made-iit/deltaflex/README.md

# DeltaFlex

This repository contains the source files and an information page on the DeltaFlex robot.
Further information is available at the [project page](https://made-iit.github.io/deltaflex/).
