made-iit/deltaflex/index.md

---
title: "DeltaFlex: an Additively Manufactured Monolithic Delta Robot with Compliant Joints"
---

# DeltaFlex: an Additively Manufactured Monolithic Delta Robot with Compliant Joints

<hr style="height:1px"> 

Alberto Parmiggiani, Emilio Ottonello, Seyyed Masoud Kargar, Mario Baggetta, Guangbo Hao, Giovanni Berselli

<video width=100% controls src="media/video_deltaflex.mp4" type="video/mp4"></video>

### Links

##### [Source files](https://github.com/made-iit/deltaflex) - [Preprint](https://github.com/made-iit/deltaflex/raw/main/media/preprint_deltaflex.pdf) - [Paper]()* - [Bibtex](https://github.com/made-iit/deltaflex/raw/main/media/bibtex.bib)
*[TODO: add paper link when available online] 

### Abstract

This study presents the design and validation of a compliant Delta robot created through additive manufacturing (AM) with a monolithic structure. The use of AM expedites the development cycle of robots, enabling faster prototype development and deployment, as well as facilitating experimentation with new robot kinematics. The use of compliant joints poses a challenge in achieving substantial workspaces for robots. However, parallel architectures are well-suited for implementing flexible joints because they require lower ranges of motion for individual joints than serial architectures. Thus the Delta configuration was chosen for this study. A Design for Additive Manufacturing (DfAM) strategy was adopted to minimize the need for support structures and maximize mechanical strength. The overall performance of the Delta was evaluated quantitatively in terms of stiffness and precision. The stiffness test aimed to measure the device's capability to withstand applied loads, while the repeatability test assessed the robot's precision and accuracy. Moreover, FEM verification was adopted. Structural simulations are a powerful tool for verifying the experimental results of a robotic system. The approach presented in this work offers an interesting avenue for robot design with significant potential for future advancements and practical applications and sheds light on the trade-offs that designers should consider when adopting this methodology.

<hr style="height:1px"> 

**Published in Proc. of ASME IDETC-CIE 2023 - © 2023 ASME**
