made-iit/deltaflex/hardware/bom.md

# Bill of materials

To assemble the DeltaFlex the following objects need to be purchased:

- 3xNema 17 stepper motors;
- 3xTiming pulleys for S2M belt, 14 teeth;
- 3xS2M timing belt; 
- 12xball bearings (inner diameter 4 mm, outer diameter 13 mm, width 5 mm);
- 12xdowel pin (diameter 4 mm, length 24 mm);
- 6xm4 brass inserts;
- 6xm4 flat head screws;
- 6xm4 set screws (length 25 mm);
- 6xm4 bolts.
