made-iit/deltaflex/hardware/mws_021_p_003.stp

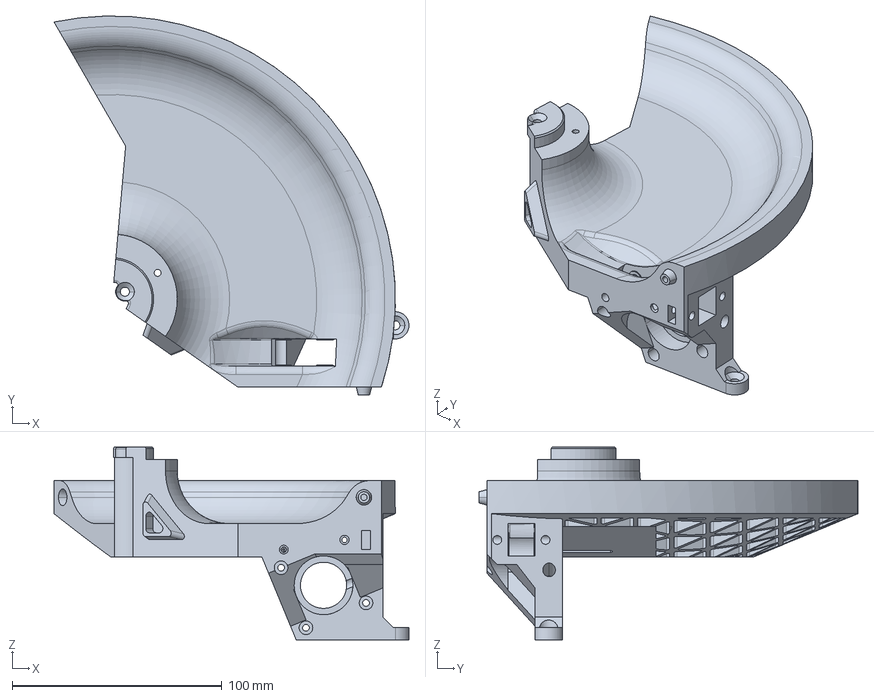
[picture p1: CAD file, 2023-08-22, last stored version]
hardware/mws_021_p_003.stp
169.3 x 180.7 x 92.0 mm
