made-iit/deltaflex/hardware/mws_021_p_005.stp

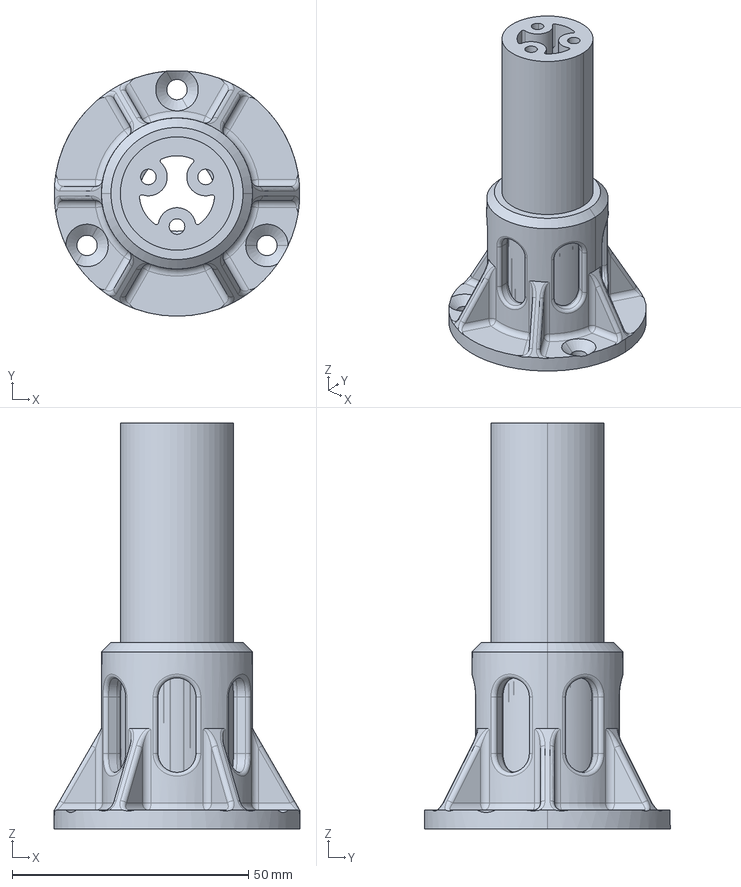
[picture p2: CAD file, 2023-08-22, last stored version]
hardware/mws_021_p_005.stp
52.0 x 52.0 x 86.0 mm
