made-iit/deltaflex/hardware/mws_021_a_001_assembly_instructions.md

# DeltaFlex assembly instructions

## Before you begin

Note: The assembly of the cover and of the driving electronics are left out of the current assembly as one might want to make the covers in a different way or use different driving electronics.

## Assembly sequence

1. After sourcing all components start by assembling the six `MWS_021_G_002` sub-assemblies.
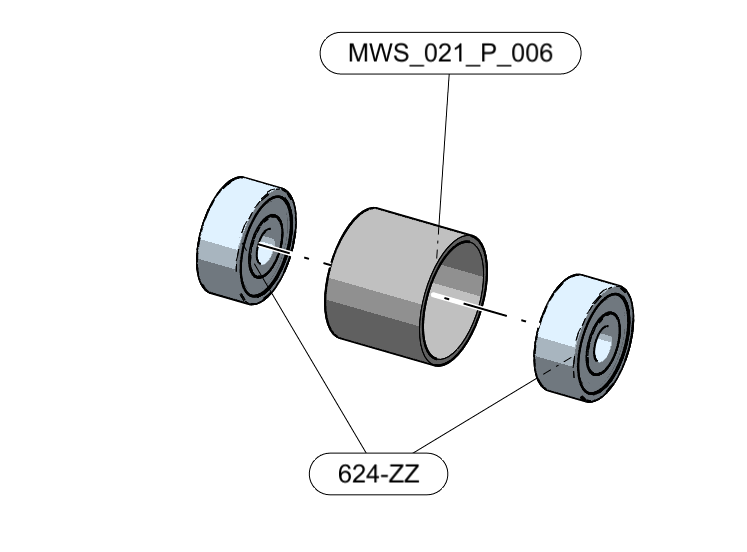
[picture p3: hardware/assembly_illustrations/illustration_01_bearings_g002.png]

1. Proceed to the assembly of the three `MWS_021_G_001` by:
   1. assemblies by assembling the stepper motors.
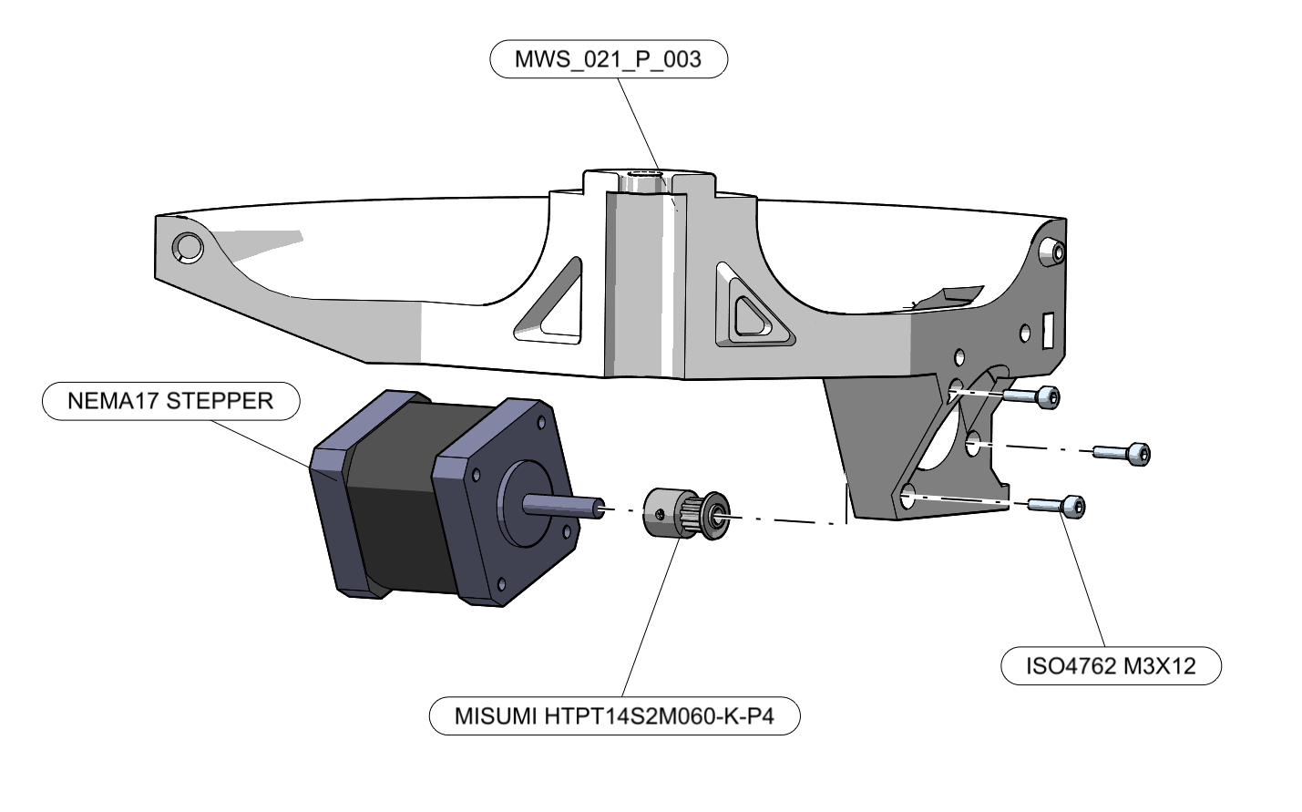
[picture p4: hardware/assembly_illustrations/illustration_02_support_g001.png]
   

   1. Insert bearing groups and fix with pins
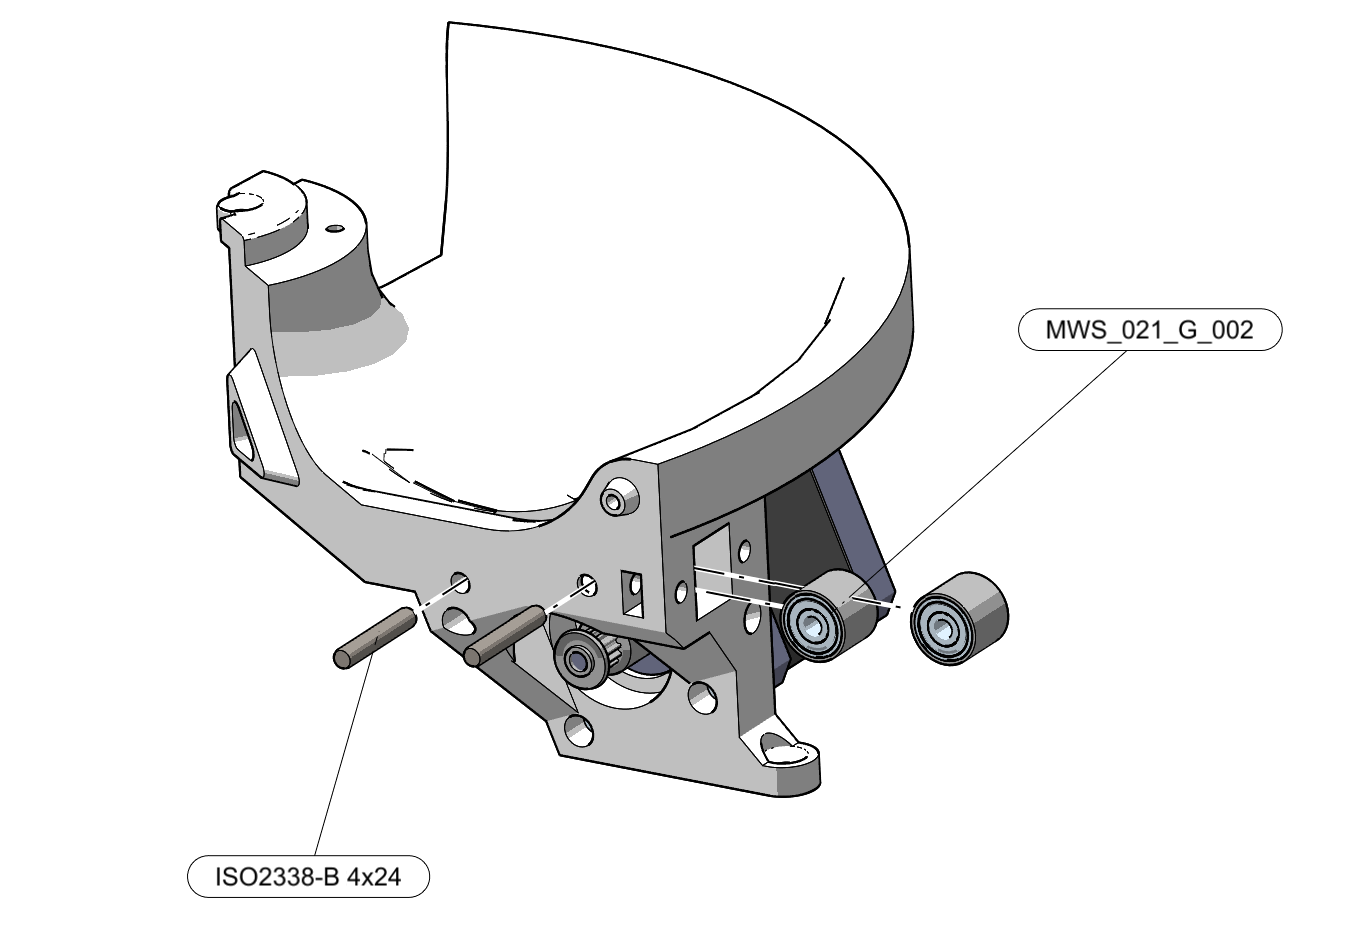
[picture p5: hardware/assembly_illustrations/illustration_04_bearings_insertion.png]

   1. Assemble tensioner set screws and nuts
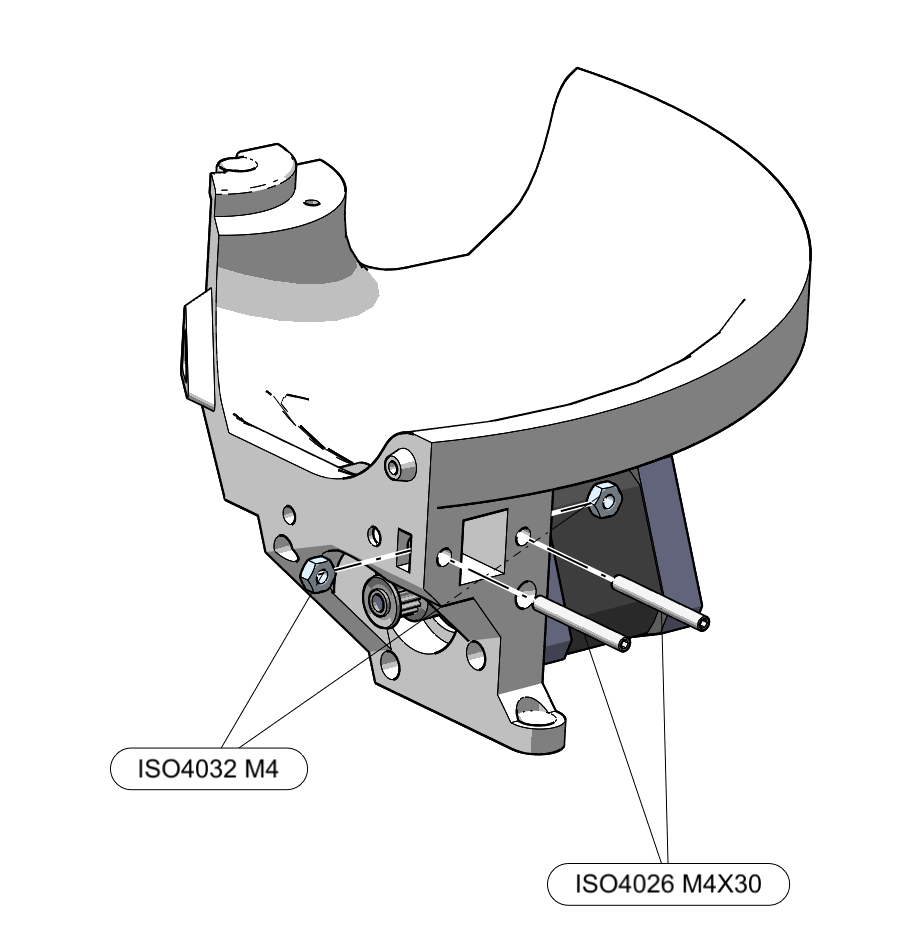
[picture p6: hardware/assembly_illustrations/illustration_05_tensioners.png]

   1. Route the timing belt through its path between the rollers and the driving shaft
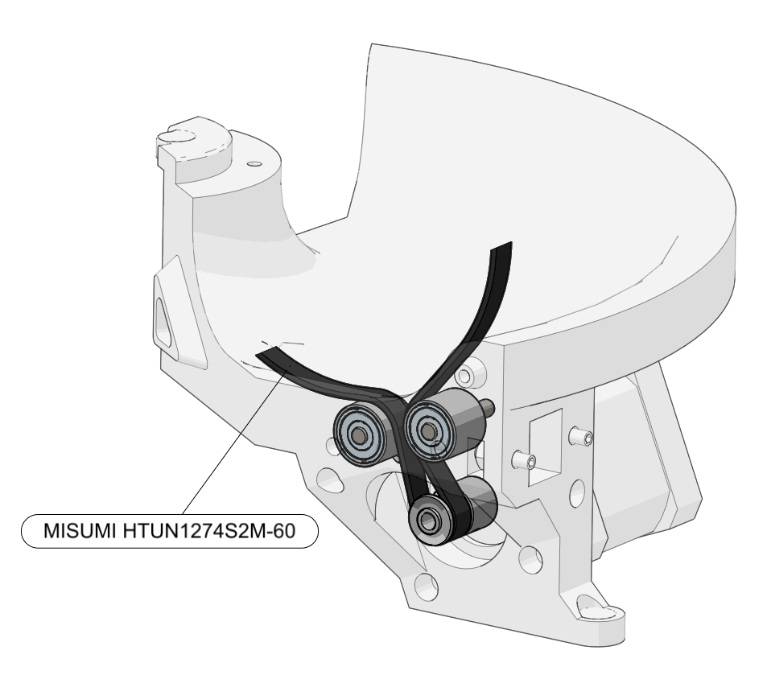
[picture p7: hardware/assembly_illustrations/illustration_06_belt_routing.png]

Leave the belt "free".
1. Mount the central support part on the base
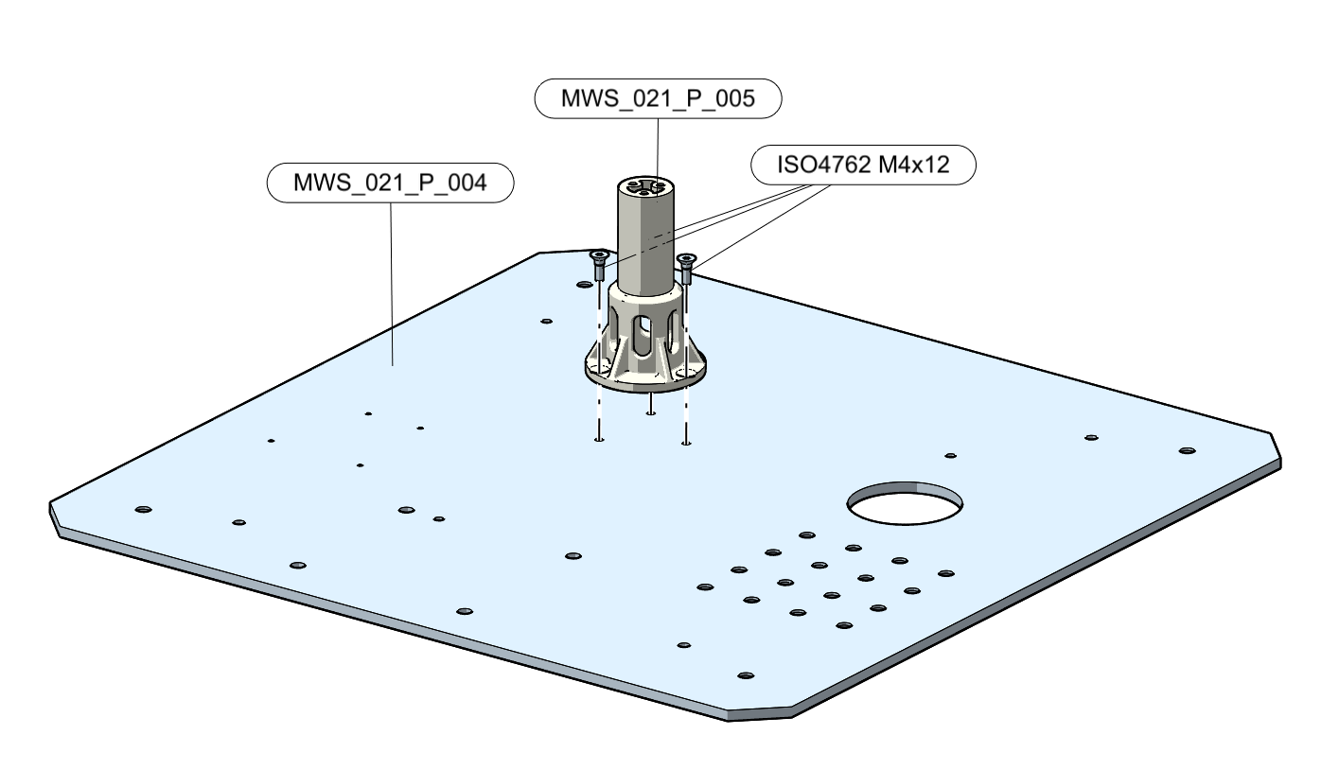
[picture p8: hardware/assembly_illustrations/illustration_07_tower_on_base.png]

1. Mount the three actuator groups `MWS_021_G_001` on the base
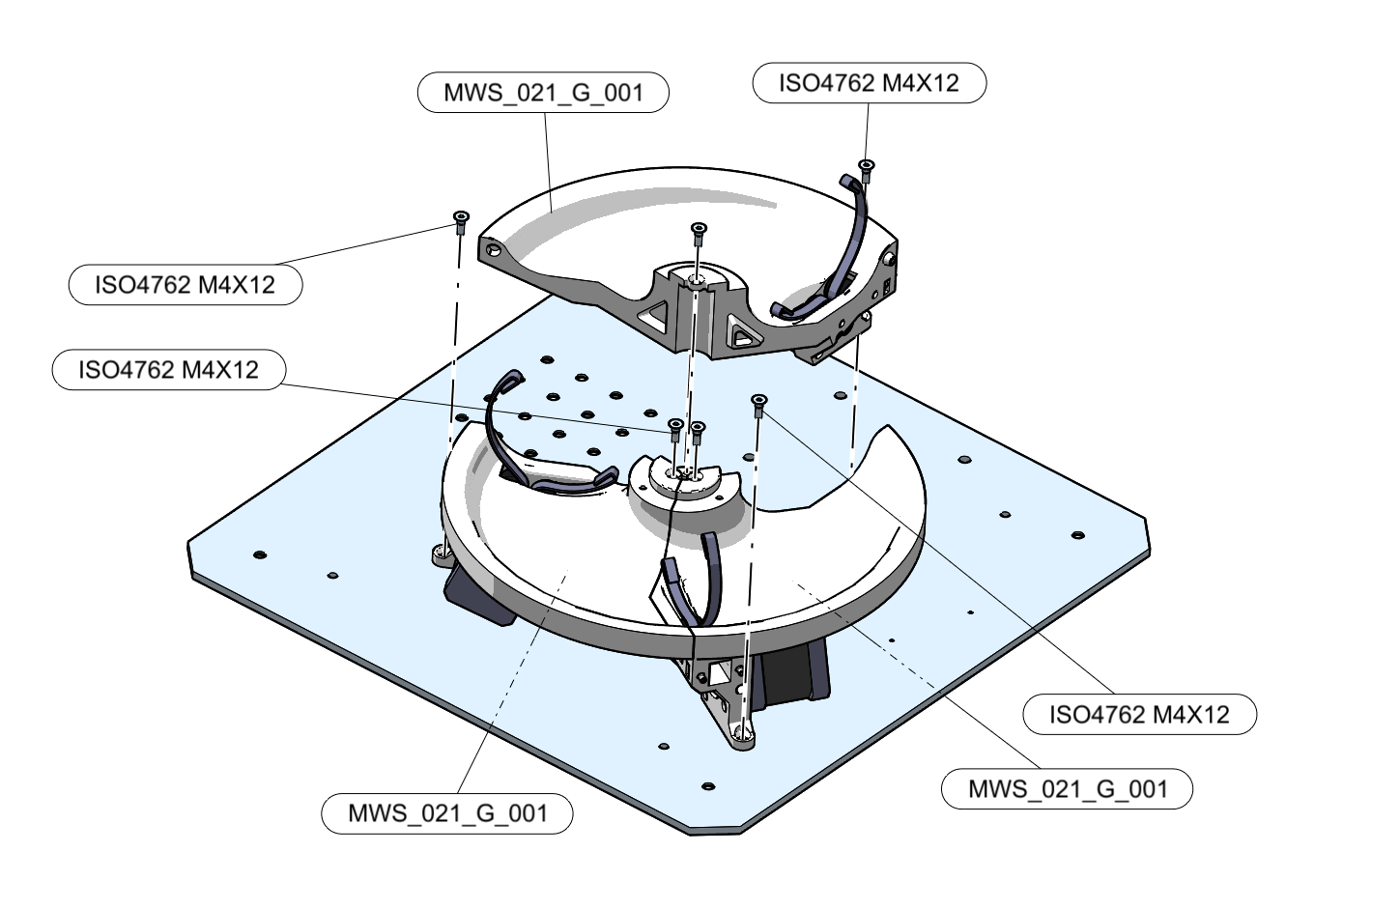
[picture p9: hardware/assembly_illustrations/illustration_08_actuator_groups_on_base.png]

1. Finally mount the *DeltaFlex* mechanism on the support structure
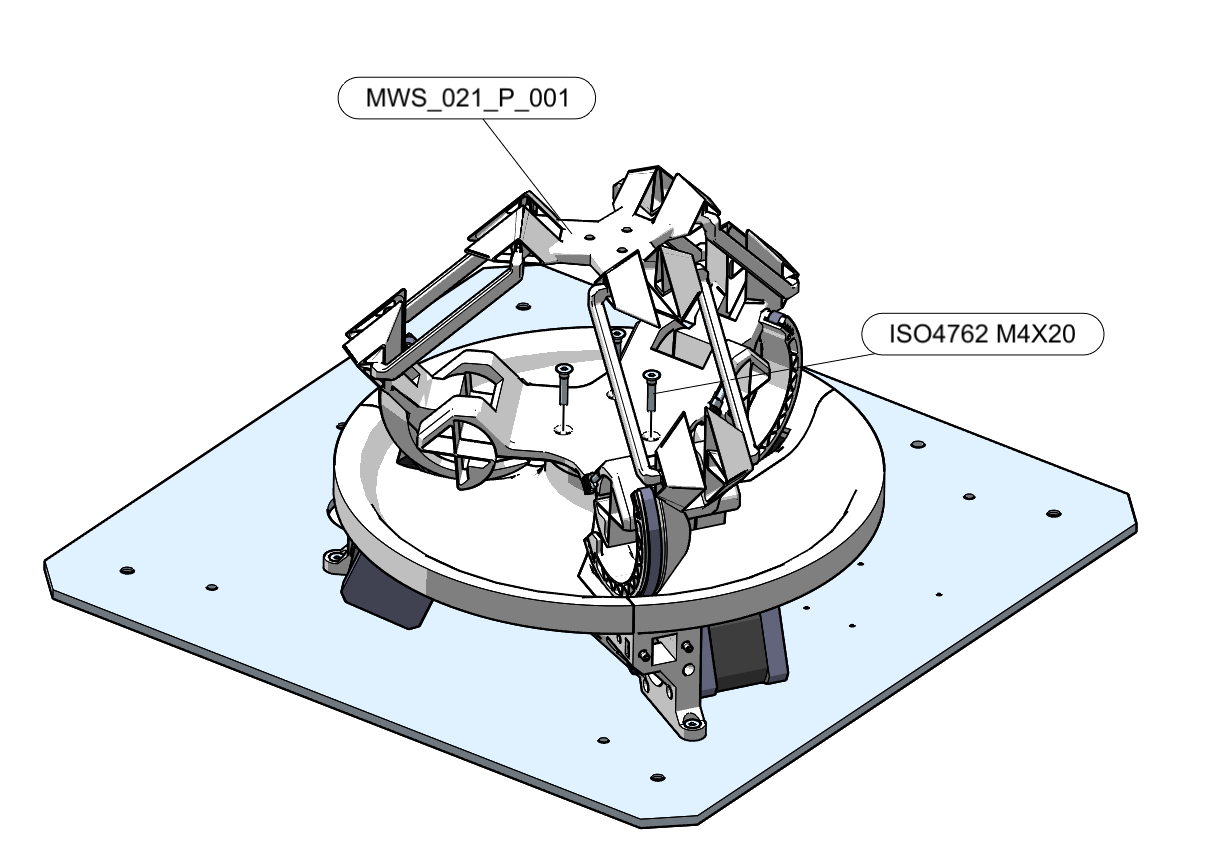
[picture p10: hardware/assembly_illustrations/illustration_09_main_robot_assembly.png]

When doing so take care to route the cables of the limit switches through their designated path through the centre of the central support part to the driving electronics
1. attach the belt end to the driven pulley
1. tighten the belt appropriately by screwing the tensioning screws
1. if the timing belt is too long remove a few teeth and repeat the belt tensioning step
