made-iit/deltaflex/hardware/assembly_illustrations/illustration_03_support_g001_rear_ view.png

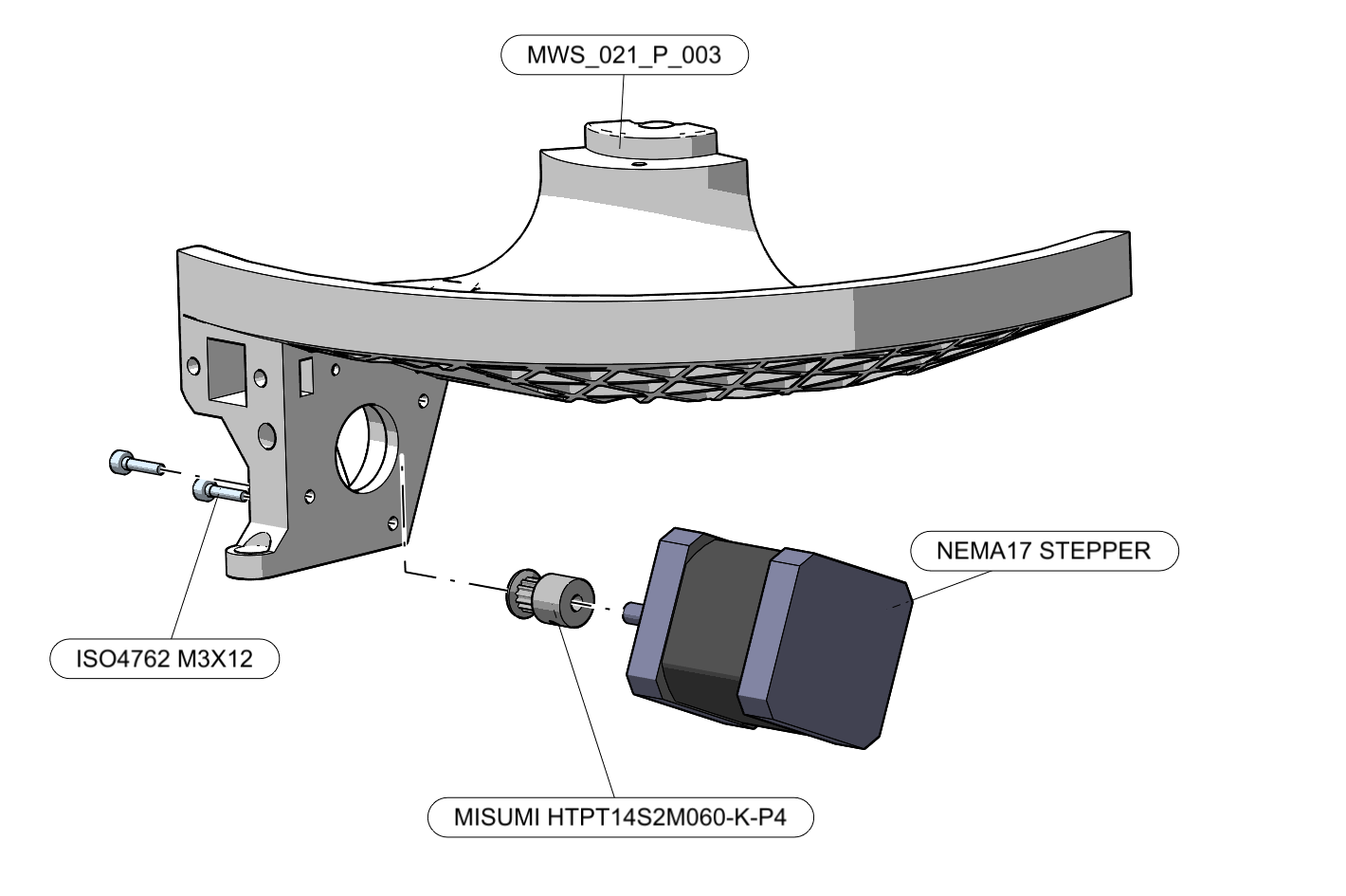
hardware/assembly_illustrations/illustration_03_support_g001_rear_ view.png
