made-iit/deltaflex/(commit log)

2023-08-22 Emilio: I upload the steps of the main files
    [mws_021_p_003.stp, mws_021_p_005.stp]
2023-09-21 added readme, bom and assembly instructions
    [mws_021_p_003.stp, mws_021_p_005.stp]
2023-09-21 adding assembly instructions
2023-09-21 completed assembly instructions (maybe)
